Sallearns99/semg-controlled-robotic-arm/emg_ws/src/rotatedauto/meshes/l2.STL

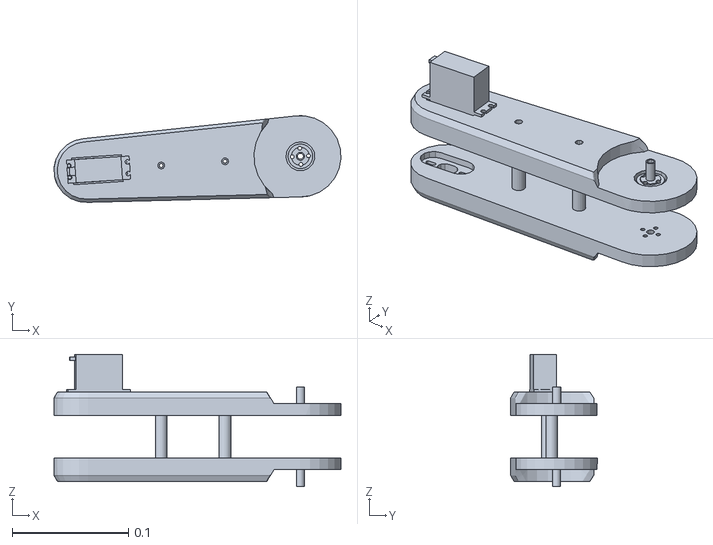
[picture p25: CAD file, 2026-07-03]
emg_ws/src/rotatedauto/meshes/l2.STL
0.247 x 0.0746 x 0.114
