Sallearns99/semg-controlled-robotic-arm/emg_ws/src/rotatedauto/meshes/l5.STL

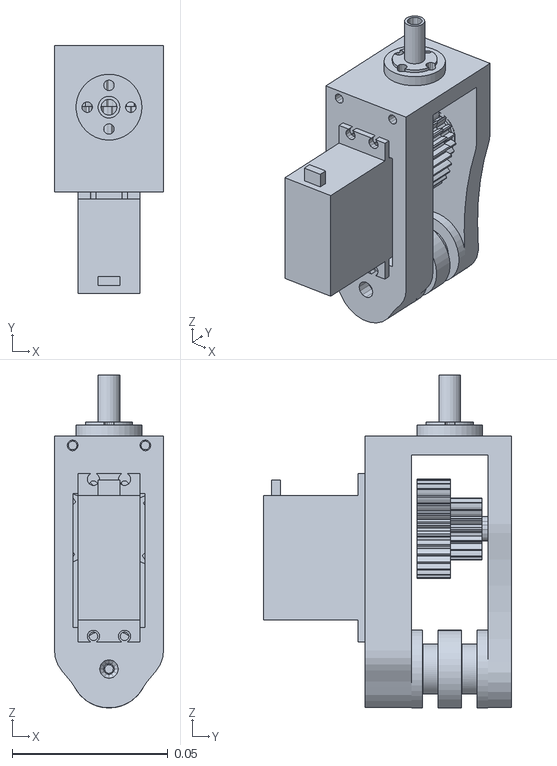
[picture p26: CAD file, 2026-07-03]
emg_ws/src/rotatedauto/meshes/l5.STL
0.035 x 0.0795 x 0.107
