Sallearns99/semg-controlled-robotic-arm/emg_ws/src/rotatedauto/meshes/base_link.STL

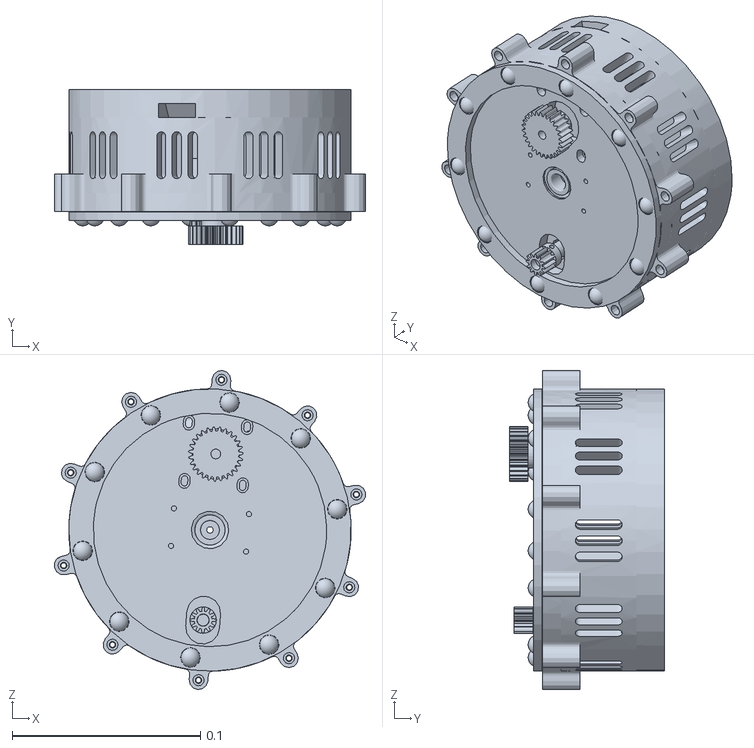
[picture p27: CAD file, 2026-07-03]
emg_ws/src/rotatedauto/meshes/base_link.STL
0.165 x 0.0825 x 0.17
