Sallearns99/semg-controlled-robotic-arm/emg_ws/src/rotatedauto/meshes/l4.STL

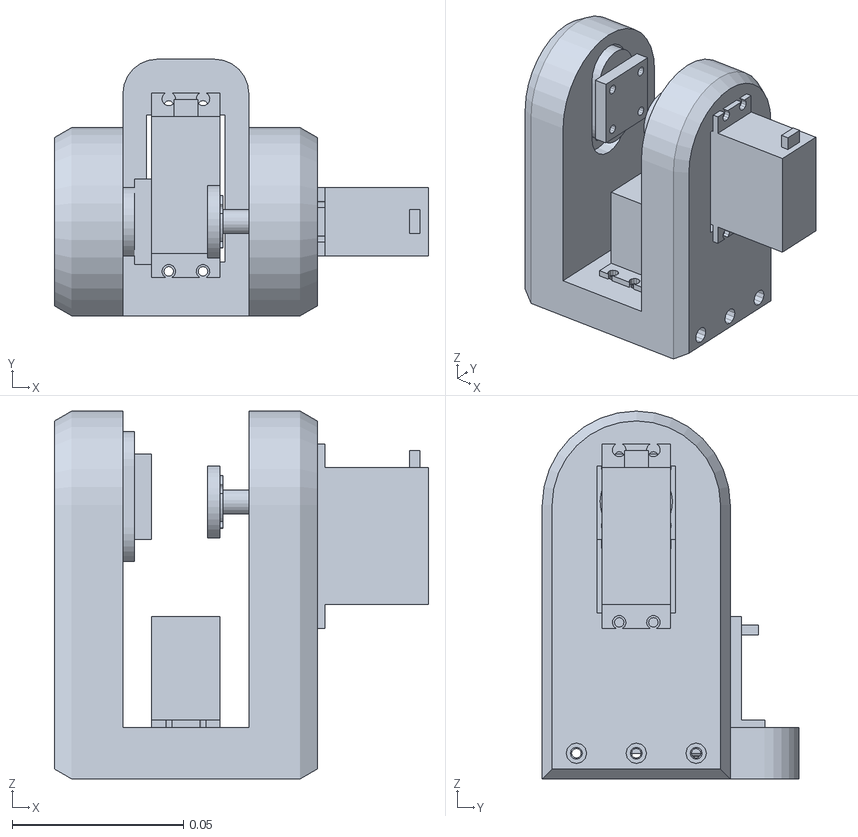
[picture p28: CAD file, 2026-07-03]
emg_ws/src/rotatedauto/meshes/l4.STL
0.109 x 0.075 x 0.107
