Sallearns99/semg-controlled-robotic-arm/emg_ws/src/rotatedauto/meshes/l6l.STL

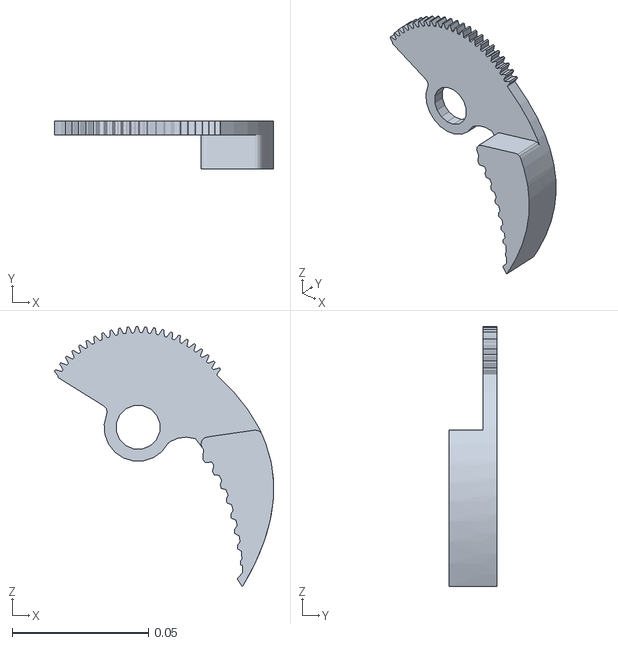
[picture p29: CAD file, 2026-07-03]
emg_ws/src/rotatedauto/meshes/l6l.STL
0.0805 x 0.0175 x 0.0955
