Sallearns99/semg-controlled-robotic-arm/emg_ws/src/rotatedauto/meshes/l6r.STL

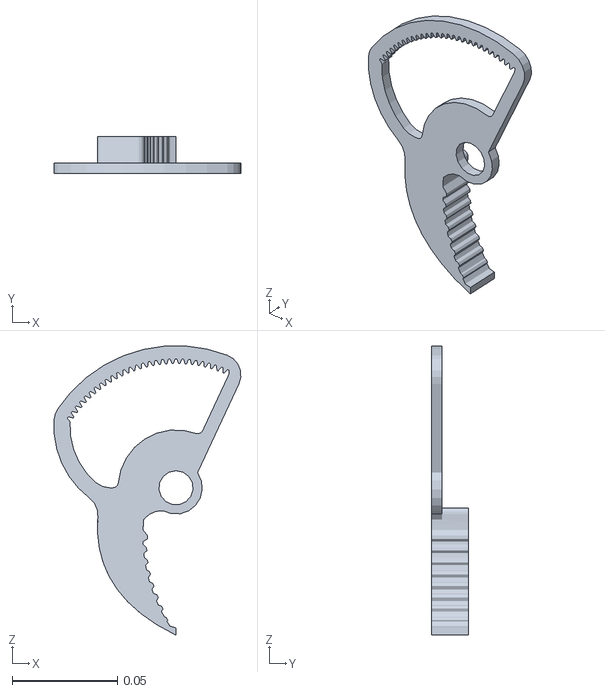
[picture p30: CAD file, 2026-07-03]
emg_ws/src/rotatedauto/meshes/l6r.STL
0.0886 x 0.0175 x 0.137
