Sallearns99/semg-controlled-robotic-arm/emg_ws/src/rotatedauto/meshes/l3.STL

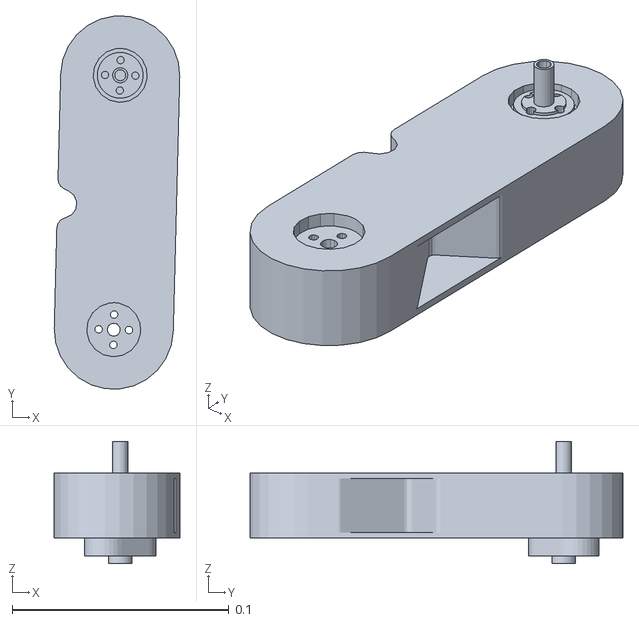
[picture p31: CAD file, 2026-07-03]
emg_ws/src/rotatedauto/meshes/l3.STL
0.058 x 0.172 x 0.0565
