Sallearns99/semg-controlled-robotic-arm/emg_ws/src/rotatedauto/meshes/l1.STL

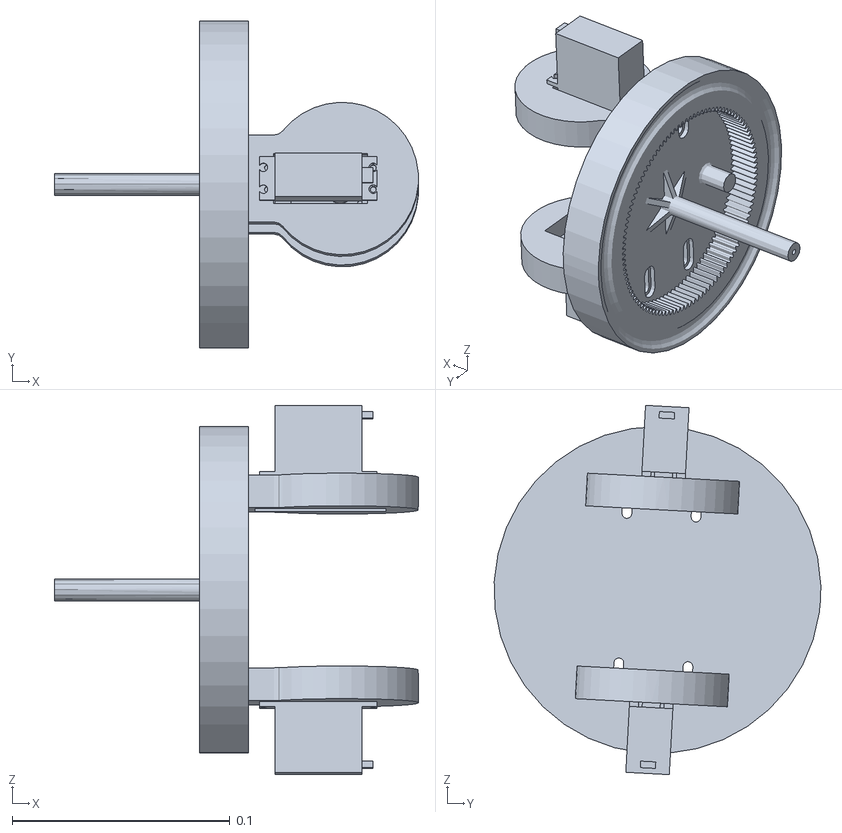
[picture p32: CAD file, 2026-07-03]
emg_ws/src/rotatedauto/meshes/l1.STL
0.167 x 0.15 x 0.169
