Sallearns99/semg-controlled-robotic-arm/emg_ws/emg_ml/docs/results/v4_test_confusion_gated.png

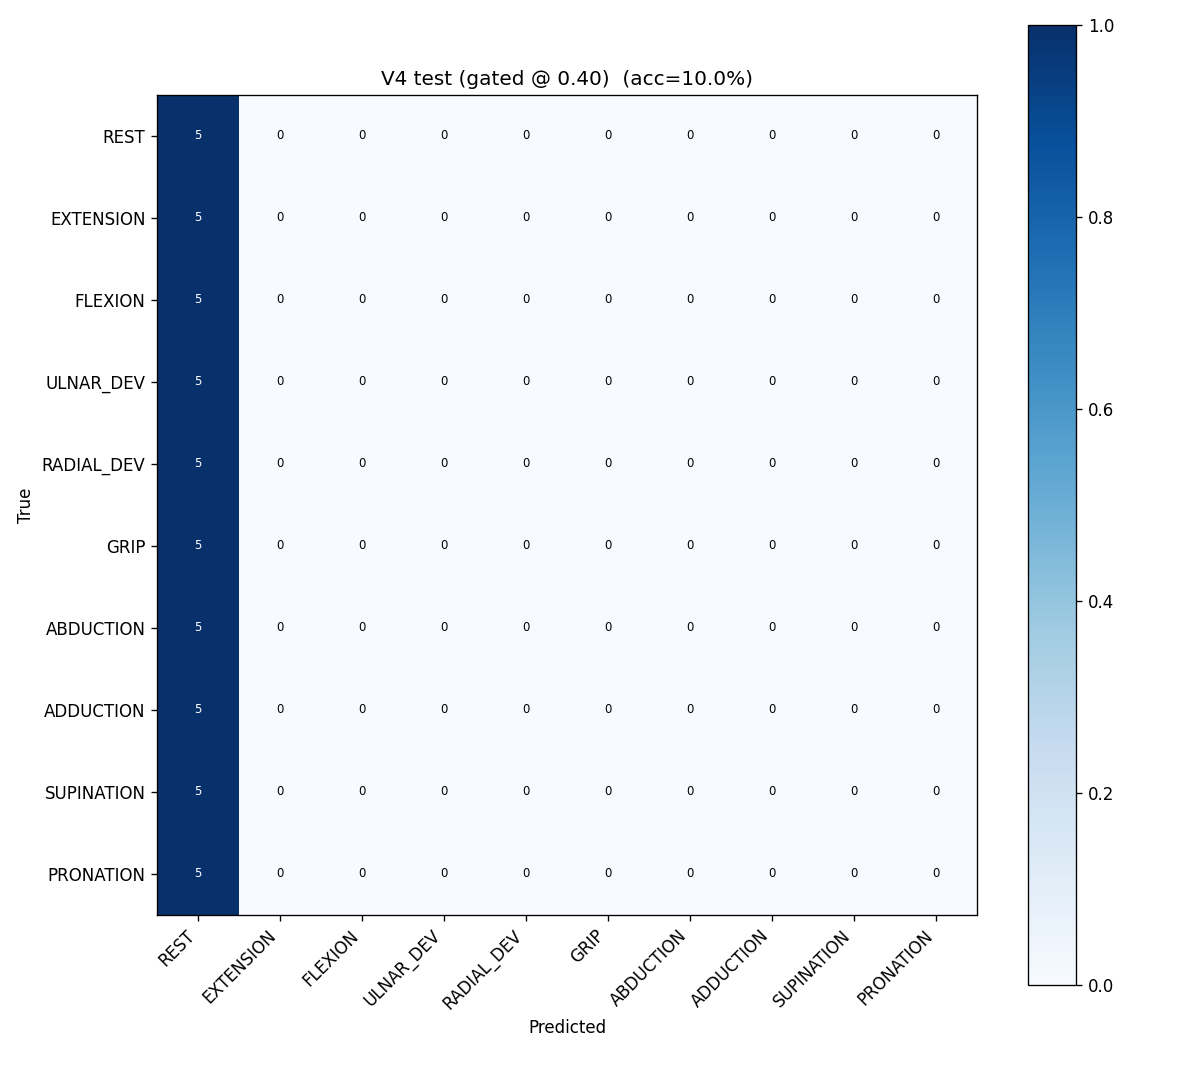
emg_ws/emg_ml/docs/results/v4_test_confusion_gated.png
